LaskaKit/ESP12-Board/Production/ESP12-LPKit_top_bom.csv

Comment | Designator | Footprint | LCSC Part #
10k | R1 R2 R3 R4 R5 | R0603
10k | R9 R10 | R0402
22uF | C2 C4 C5 | C0603
100k | R8 | R0402
100nF | C1 C3 | C0603
330k | R7 | R0402 | C25778
470 | R6 | R0603
ESP-12S | ESP-12 | ESP12-SMD | C82898
HT7833 | LDO | SOT89-BCE | C50936
MMDT3904 | Q1 | SC70-6 | C268586
TS-1088R-02026 | BOOT FLASH | TS1088R02026
