LaskaKit/ESP12-Board/Production/ESP12-LPKit_LDO_SOT-23-5_top_bom - ESP-07S.csv

Comment | Designator | Footprint | LCSC Part #
10k | R1 R2 R3 R4 R5 | R0603
10k | R9 R10 | R0402
22uF | C2 C4 C5 | C0603
100k | R8 | R0402
100nF | C1 C3 | C0603
330k | R7 | R0402 | C25778
470 | R6 | R0603
ESP-07S | ESP-12 | ESP12-SMD | C82895
HT7833 | LDO | SOT23-5 | C164106
JUMPER-SMT_2_NO_NO-SILK | SLEEP | SMT-JUMPER_2_NO_NO-SILK
MMDT3904 | Q1 | SC70-6 | C968392
TS-1088R-02026 | BOOT FLASH | TS1088R02026
