LaskaKit/ESP12-Board/HW/ESP-12 Board Schematic.pdf

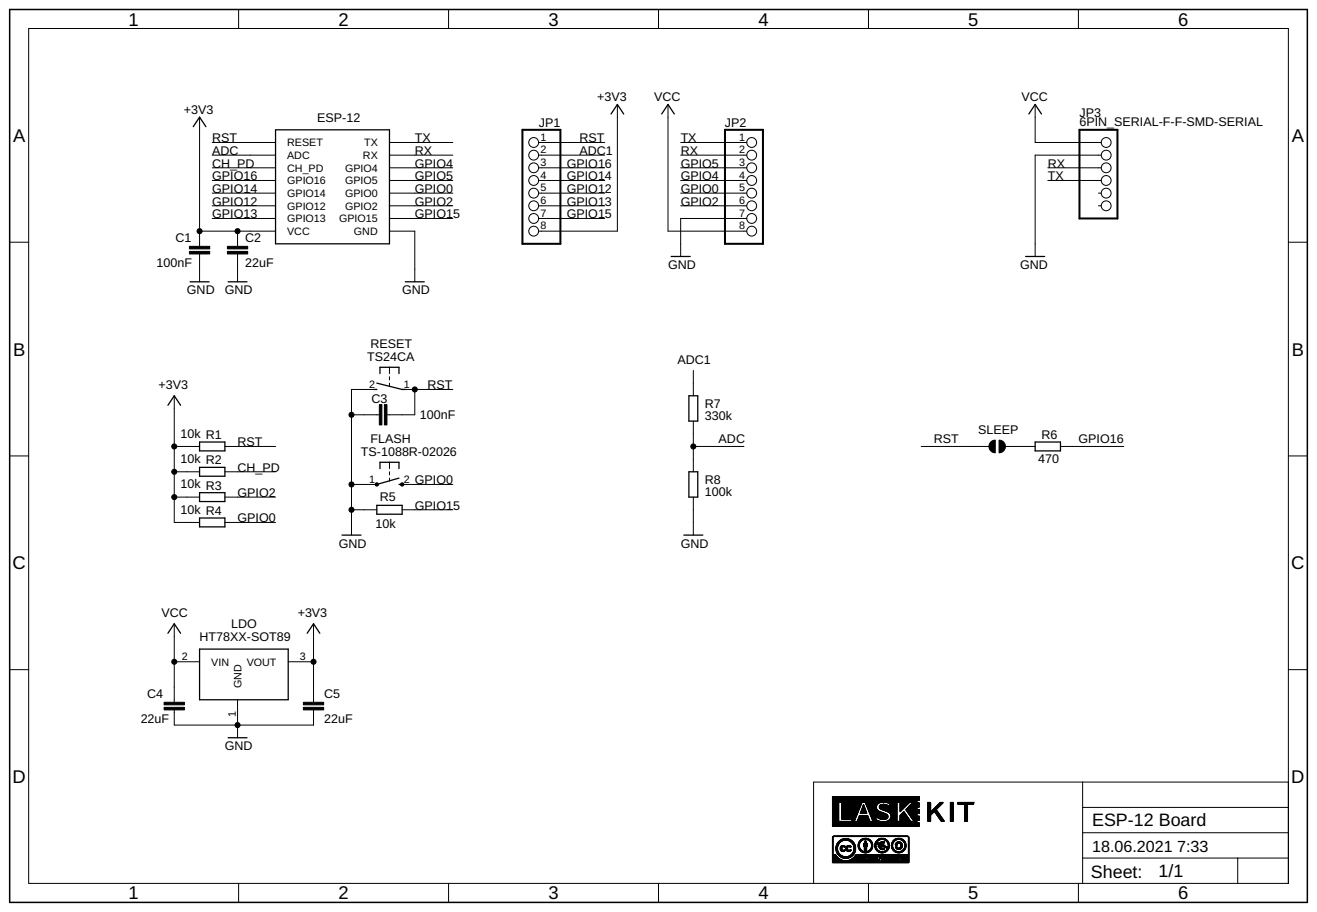
[picture p9: page 1]
