LaskaKit/ESP12-Board/HW/ESP12-LPKit_Schematic.pdf

A

A

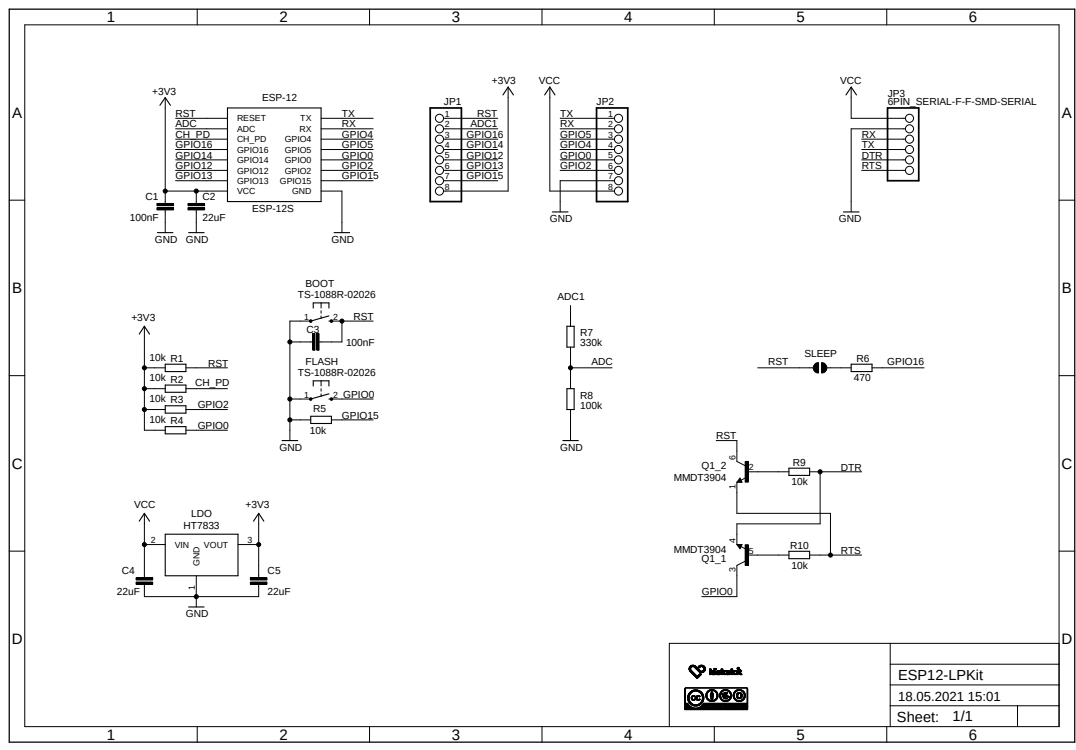
[picture p10: page 1]
