LaskaKit/ESP12-Board/HW/Schematic.pdf

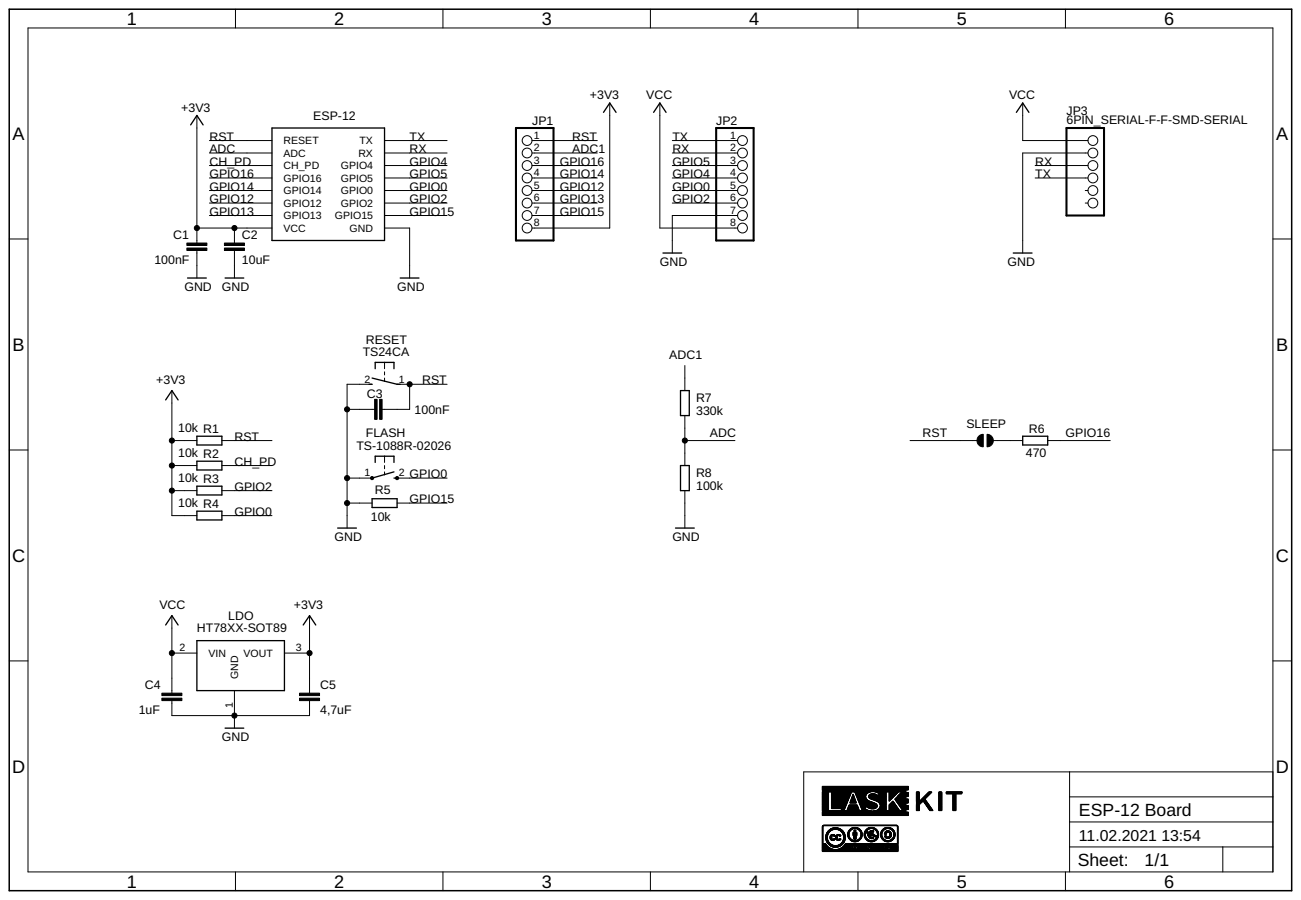
[picture p11: page 1]
