LaskaKit/ESP12-Board/HW/ESP-12 Board (osazovaci plan).pdf

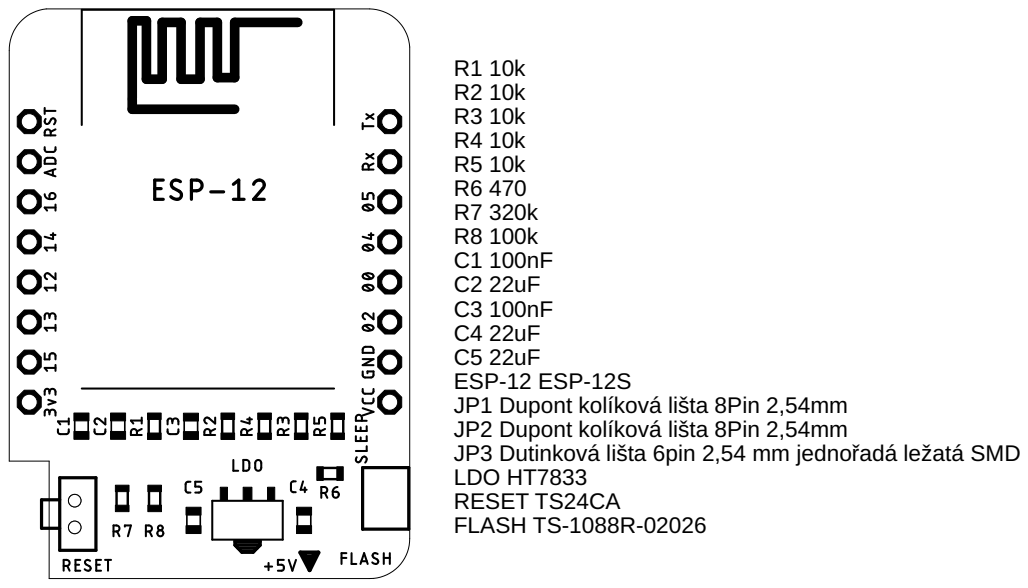
[picture p12: page 1]
