LaskaKit/ESP12-Board/(commit log)

2021-02-12 new version
    [ESP-12 Board_top_cpl.csv]
2021-02-12 change R7 to 330k, ADC to 4.3V
2021-02-12 R7 -> 330k, ADC 4v2 -> 4v3
2021-03-11 add bom
    [ESP-12 Board_top_bom.csv]
2021-07-27 no changes
    [ESP-12 Board_top_bom.csv, ESP12-LPKit_LDO_SOT-23-5_top_bom.csv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]
2022-04-21 new data
    [ESP12-LPKit_ESP32-C3_LDO_SOT-23-5_top_bom.csv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]
2022-05-26 need update to ESP32-C3
